nkout/gold/chance_pi/generated/ChancePI-DesAlex-preview.png

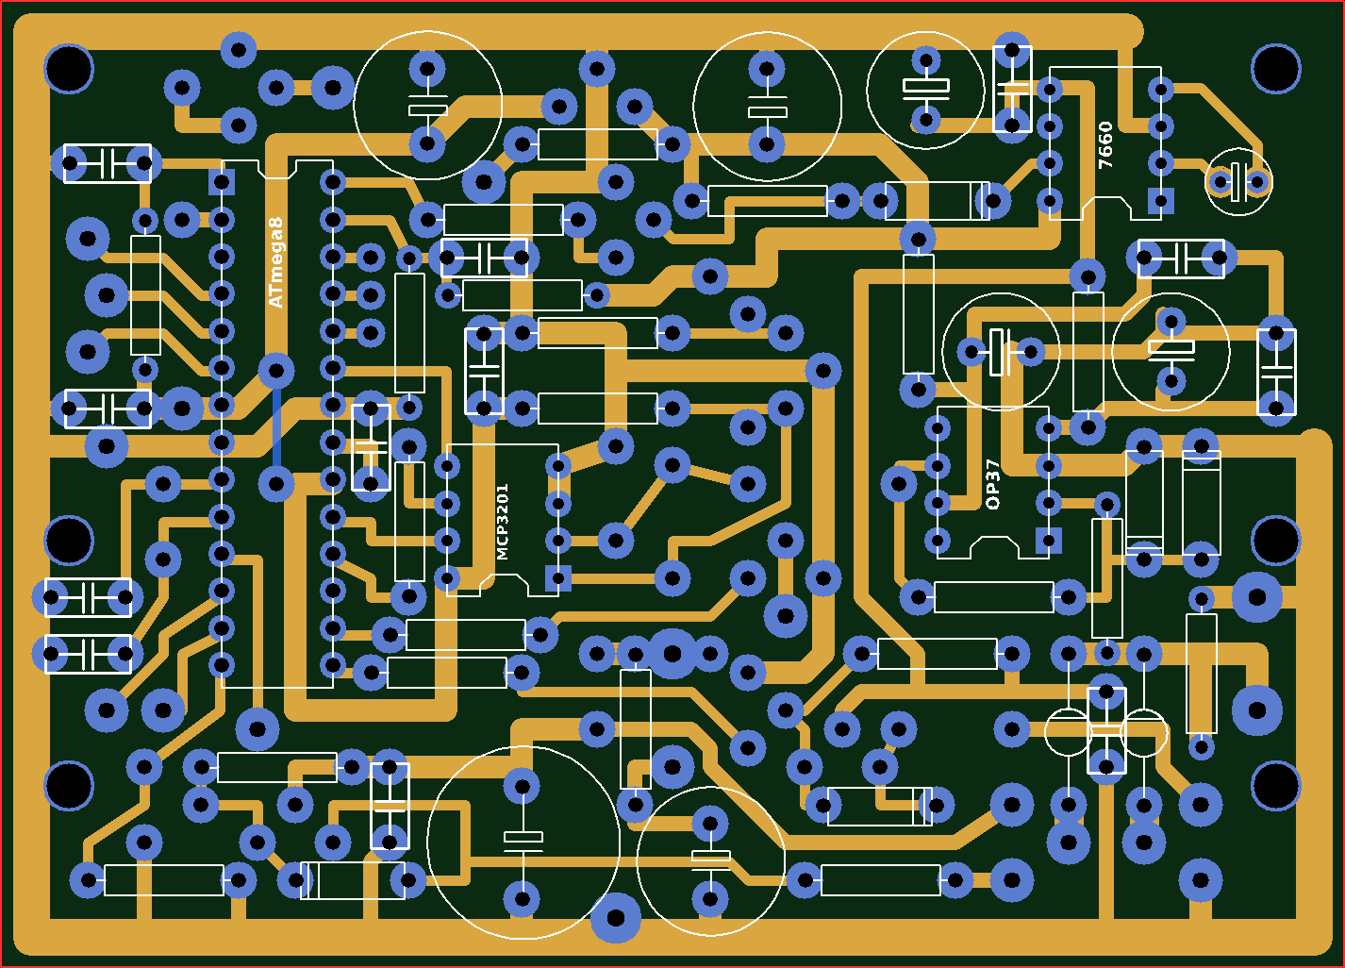
chance_pi/generated/ChancePI-DesAlex-preview.png
