nkout/gold/chance_pi/generated/ChancePI-Keyboard-preview.png

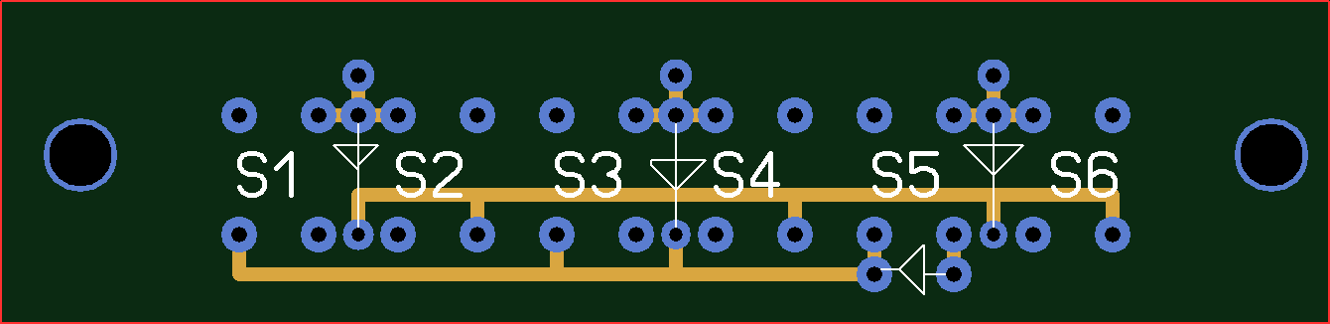
chance_pi/generated/ChancePI-Keyboard-preview.png
