nkout/gold/chance_pi/original/sheme.gif

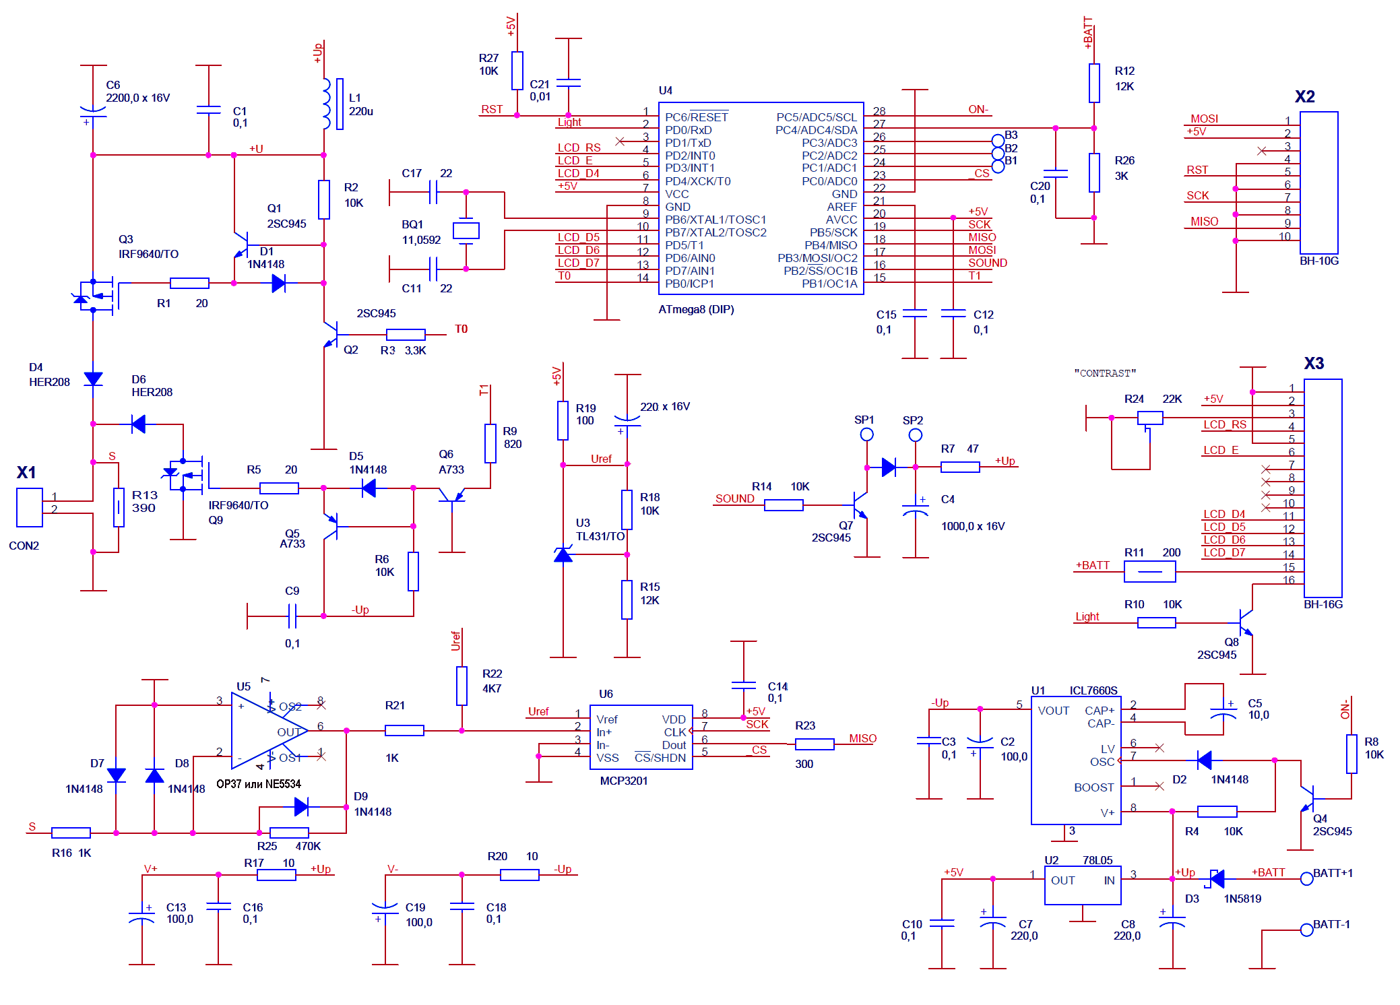
chance_pi/original/sheme.gif
