nkout/gold/tgsl/gerbers/try_03/TGSL-Geotech-v3-preview.png

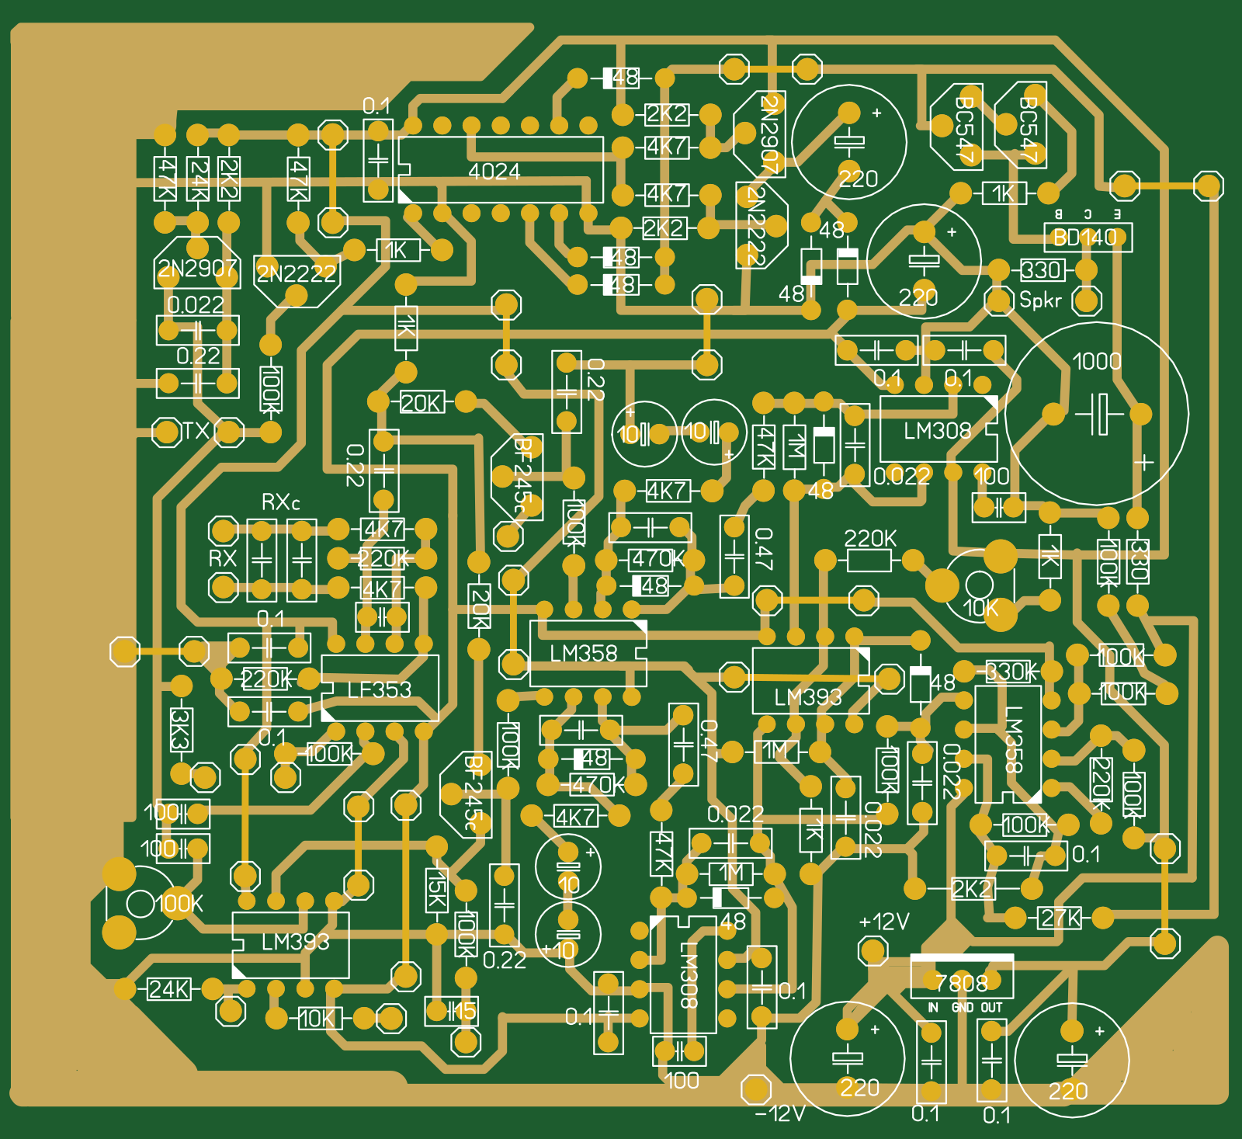
tgsl/gerbers/try_03/TGSL-Geotech-v3-preview.png
