nkout/gold/tgsl/gerbers_generated/review_03/drill_sizes.png

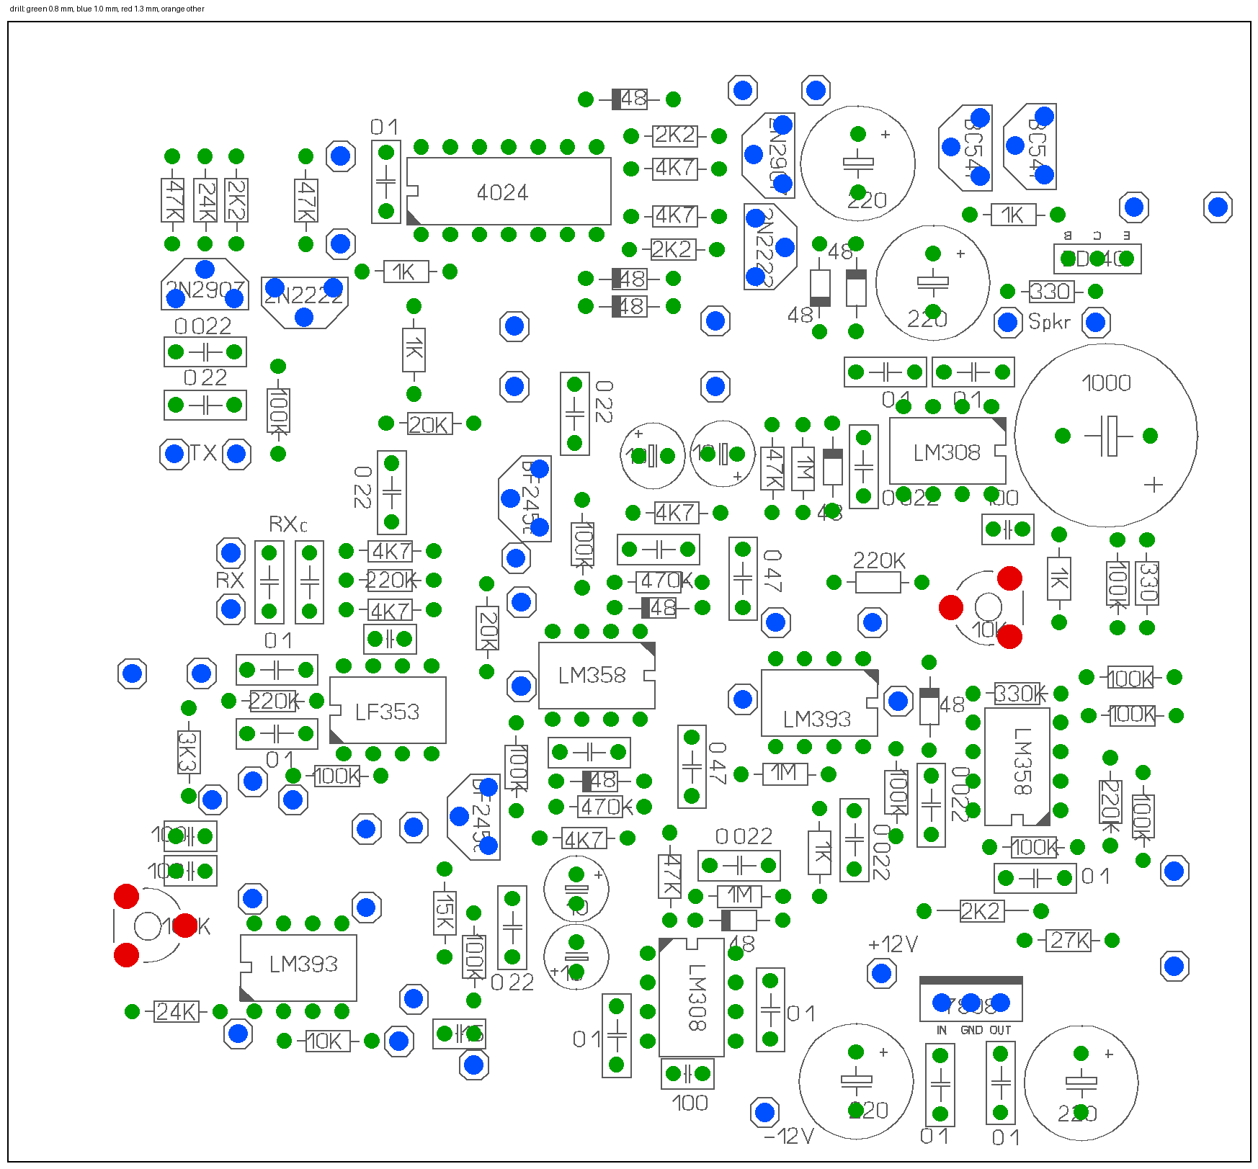
tgsl/gerbers_generated/review_03/drill_sizes.png
