nkout/gold/tgsl/parts/TGSL_PARTS1.xls

Quantity | Capacitors | Part numbers |  | Order from
3 | C8,C12,C15 | 490-3862-ND | CAP CER 220000PF 50V Y5V RADIAL (220n) | www.digikey.com
4 | C3,C4,C5,C28 | P1168-ND | 220UF 16V POLARIZED | www.digikey.com
6 | C13,C16,C20,C23,C24,C25 | 490-3826-ND | CAP CER 22000PF 50V X7R RADIAL (22n) | www.digikey.com
2 | C18,C21 | 490-3865-ND | CAP CER 470000PF 50V Y5V RADIAL (470n) | www.digikey.com
4 | C9,C10,C19,C22 | 490-3677-ND | CAP CER 100PF 50V C0G RADIAL | www.digikey.com
4 | C14,C17, | P5148-ND | 10UF 25V POLARIZED | www.digikey.com
 |  | or..
2 | C14,C17, | P1175-ND | 4.7UF BIPOLAR | www.digikey.com
1 | C27 | P10279-ND | CAP 1000UF 25V ELECT FC RADIAL | www.digikey.com
1 | C7 | 490-3679-ND | CAP CER 10PF 50V C0G RADIAL | www.digikey.com
11 | C26 (& ALL BYPASS CAPACITORS) | 4452634-ND | CAP CER 0.1UF 100V X7R 10% RAD | www.digikey.com
1 | C11 | 478-4845-ND | CAP CER 15PF 100V 5% NP0 RADIAL | www.digikey.com
1 | C1 | P4667-ND | CAP .22UF 50V POLY B SERIES | www.digikey.com
1 | C2 | P4586-ND | CAP .022UF 50V POLY B SERIES | www.digikey.com
1 | C6 | P4515-ND | CAP .015UF 50V STACK METAL FILM | www.digikey.com
 | Resistors
4 | R32,R34,R3,R6 | P47KBACT-ND | 47K | www.digikey.com
11 | R17,R18,R22,R23,R28,R30,R40,R42,R49,R50,R8 | P100KBACT-ND | 100K | www.digikey.com
1 | R6 | P22KBACT-ND | 22K | www.digikey.com
6 | R9,R10,R13,R14,R41,R53 | P4.7KBACT-ND | 4.7K | www.digikey.com
1 | R21 | 24KQBK-ND | 24K | www.digikey.com
2 | R25,R26 | 20KQBK-ND | 20K | www.digikey.com
1 | R45, | 27KQBK-ND | 27K | www.digikey.com
2 | R48,R51 | 200KQBK-ND | 200K | www.digikey.com
3 | R5 | P330BACT-ND | 330 | www.digikey.com
1 | R43 | P330KBACT-ND | 330K | www.digikey.com
3 | R33,R35,R54 | P1.0MBACT-ND | 1M | www.digikey.com
2 | R29,R31, | P470KBACT-ND | 470K | www.digikey.com
5 | R27,R37,R38,R4,R7 | P1.0KBACT-ND | 1K | www.digikey.com
1 | R24 | P15KBACT-ND | 15K | www.digikey.com
1 | R20 | P10KBACT-ND | 10K | www.digikey.com
1 | R19 | P3.3KBACT-ND | 3.3K | www.digikey.com
3 | R15,R16,R39 | P220KBACT-ND | 220K | www.digikey.com
4 | R12,R44,R11,R6 | 2.2KQBK-ND | 2.2K | www.digikey.com
 | ICs
1 | U100 | 296-2042-5-ND | CD4024BE | www.digikey.com
1 | U108 | LM7808CTFS-ND | IC REG 1A POS VOLT 3TERM TO-220 | www.digikey.com
1 | U101A,U101B | LF353NFS-ND | LF353N IC OPAMP JFET DUAL HS 8-DIP | www.digikey.com
2 | U102A,U102B,U106A,U106B | LM393AN-ND | LM393AN IC COMPRTR DUAL 0-70DEG C 8-DIP | www.digikey.com
2 | U103A,U103B,U107A,U107B | LM358NFS-ND | LM358N IC OPAMP DUAL 0-70DEG C 8-DIP | www.digikey.com
2 | U104,U105 | 296-7185-5-ND | TL071ACP | www.digikey.com
 |  | or..
 |  | 23464 | LM308N | www.jameco.com
 | Diodes
10 | D3,D4,D5,D6,D7,D8,D9,D10,D11,D12 | 1N4148DICT-ND | DIODE SWITCHING 75V D0-35
 | Transistors
1 | TR3 | BD14016STU-ND | TRANSISTOR PNP 1.5A 80V | www.digikey.com
2 | TR2,TR9 | BC547CGOS-ND | TRANSISTOR NPN 45V | www.digikey.com
2 | TR6,TR8 | P2N2222AGOS-ND | TRANS GP SS NPN LP 40V TO92 | www.digikey.com
2 | TR4,TR5 | 512-BF247A | BF247A | www.mouser.com
 |  | or..
2 | TR4,TR5 | 512-J107 | J107 | www.mouser.com
2 | TR1,TR7 | 863-P2N2907AG | 2N2907 | www.mouser.com
 | Misc
1 | R36 | 652-3386F-1-104LF | 10K POT PCB MOUNT | www.mouser.com
1 | R22 |  | 100K POT LINEAR TAPER | www.mouser.com
1 | R18 |  | 100K POT LINEAR TAPER
1 |  |  | 8 OHM SPEAKER
1 |  | PC6-ND | PCB COPPER CLAD 4 X 6" 1 SIDE | www.digikey.com
6 |  | ED90048-ND | IC SOCKET 8PIN MS TIN/TIN .300 | www.digikey.com
1 |  | ED90049-ND | IC SOCKET 14PIN MS TIN/TIN .300 | www.digikey.com
