nkout/gold/tgsl/gerbers_generated/tgsl_mouser_bom_3boards_v2.csv

Mfr Part Number | Manufacturer | Quantity | Customer Part Number
MBA02040C3300FC100 | Vishay Beyschlag | 10 | R52 R55
MFR-12FTF52-1K | Yageo | 25 | R7 R27 R37 R38 R56
MFR-12FTF52-2K2 | Yageo | 15 | R1 R11 R12 R44
MFR-12FTF52-3K3 | Yageo | 10 | R19
MFR-12FTF52-4K7 | Yageo | 25 | R9 R10 R13 R14 R41 R53
MFR-12FTF52-10K | Yageo | 10 | R20
MFR-12FTF52-15K | Yageo | 10 | R24
MFR-12FTF52-20K | Yageo | 10 | R25 R26
MFR-12FTF52-24K | Yageo | 10 | R2 R21
MFR-12FTF52-27K | Yageo | 10 | R45
MFR-12FTF52-47K | Yageo | 15 | R3 R6 R32 R34
MFR-12FTF52-100K | Yageo | 35 | R8 R17 R23 R28 R30 R40 R42 R49 R50 R51ab
MFR-12FTF52-220K | Yageo | 15 | R15 R16 R39 R48
MFR-12FTF52-330K | Yageo | 10 | R43
MFR-12FTF52-470K | Yageo | 10 | R29 R31
MFR-12FTF52-1M | Yageo | 10 | R33 R35 R54
FG18C0G1H100DNT00 | TDK | 4 | C7 10p
FG18C0G1H150JNT00 | TDK | 4 | C11 15p
FG18C0G1H101JNT06 | TDK | 10 | C9 C10 100p (C19 C22 not needed w TL081)
FG28X7R1H104KNT00 | TDK | 32 | C26 + 9 bypass 100n
B32529C1224J000 | TDK | 4 | C1 220n 5% Tx tuning
MKS2D032201C00KSSD | WIMA | 10 | C8 C12 C15 220n
MKS2D022201A00KSSD | WIMA | 25 | C13 C16 C20 C23 C24 C25 22n + C2 (select)
B32529C1153J000 | TDK | 4 | C6 15n 5% Rx tuning
MKS2D034701E00KSSD | WIMA | 10 | C18 C21 470n 100V
EEU-FC1H100L | Panasonic | 13 | C14 C14b C17 C17b 10u
ECA-1HM221 | Panasonic | 13 | C3 C4 C5 C28 220u
EEU-FR1E102 | Panasonic | 3 | C27 1000u
1N4148TR | onsemi | 35 | D3-D12
BC547CTA | onsemi | 10 | TR2 TR9
PN2222ABU | onsemi | 10 | TR6 TR8 (2N2222A) rotate 180
PN2907ABU | onsemi | 10 | TR1 TR7 (2N2907A) rotate 180
BD140 | STMicroelectronics | 3 | TR3
J113 | onsemi | 10 | TR4 TR5 rotate 180
CD4024BE | Texas Instruments | 3 | U100
LF353P | Texas Instruments | 3 | U101
LM393P | Texas Instruments | 6 | U102 U106
LM358P | Texas Instruments | 6 | U103 U107
TL081CP | Texas Instruments | 6 | U104 U105
MC7808CTG | onsemi | 3 | U108
1-2199298-2 | TE Connectivity | 21 | U101-U107 sockets
1-2199298-3 | TE Connectivity | 3 | U100 socket
PT10LV10-104A2020-PM-S | Amphenol Piher | 4 | R22 GB 100k 5x10 (wiper via wire)
