nkout/gold/(list of files, cad)

Other CAD files:
tgsl/trevo/proteus/TREVO METAL DISC.DXF
