nkout/gold/tgsl/design/PCB.pdf

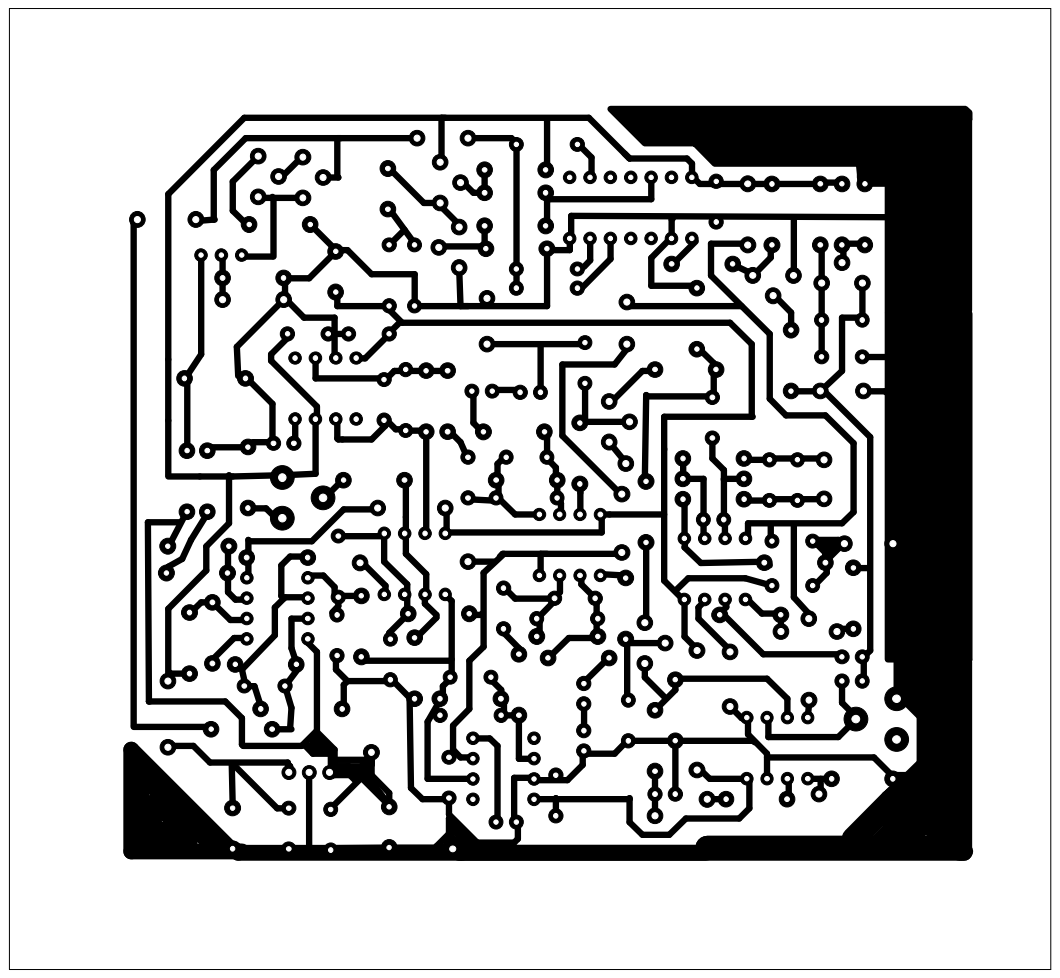
[picture p80: page 1]
