nkout/gold/tgsl/design/Placement OC.pdf

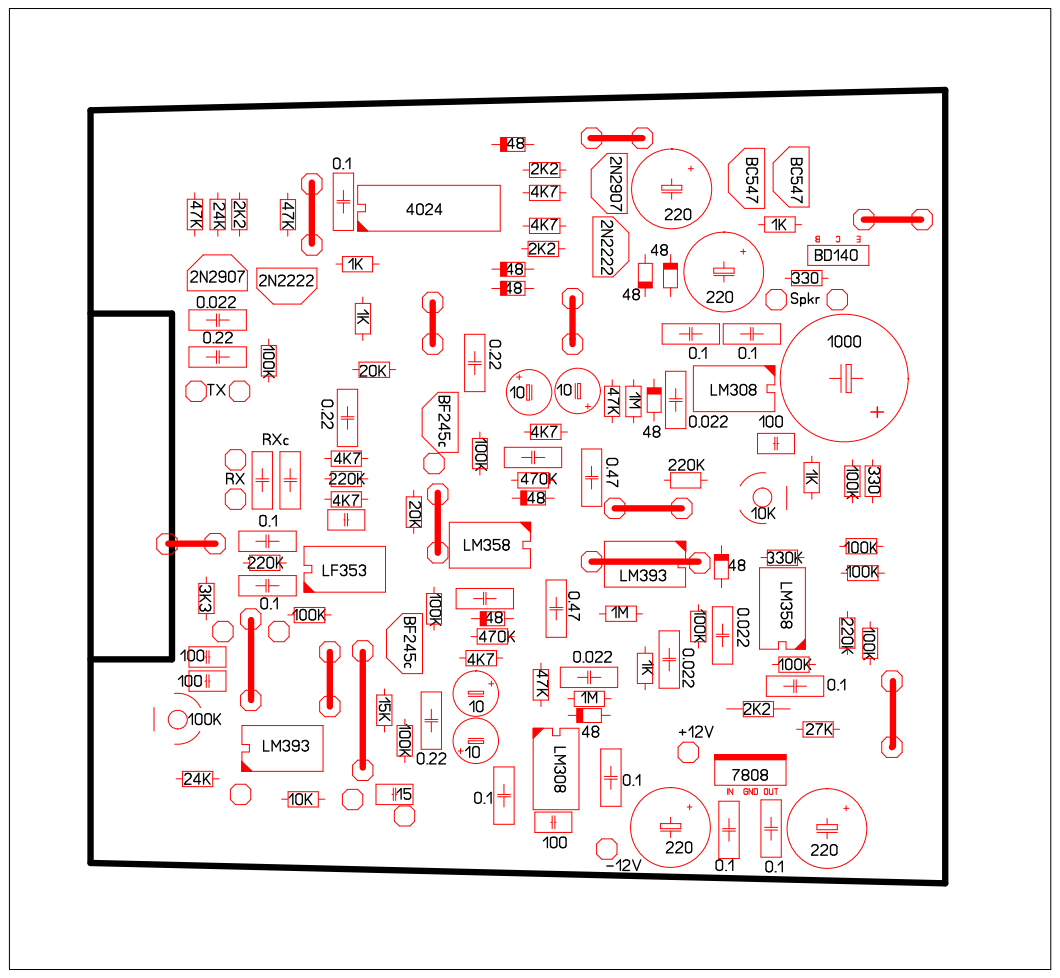
[picture p81: page 1]
