nkout/gold/tgsl/design/Placement.pdf

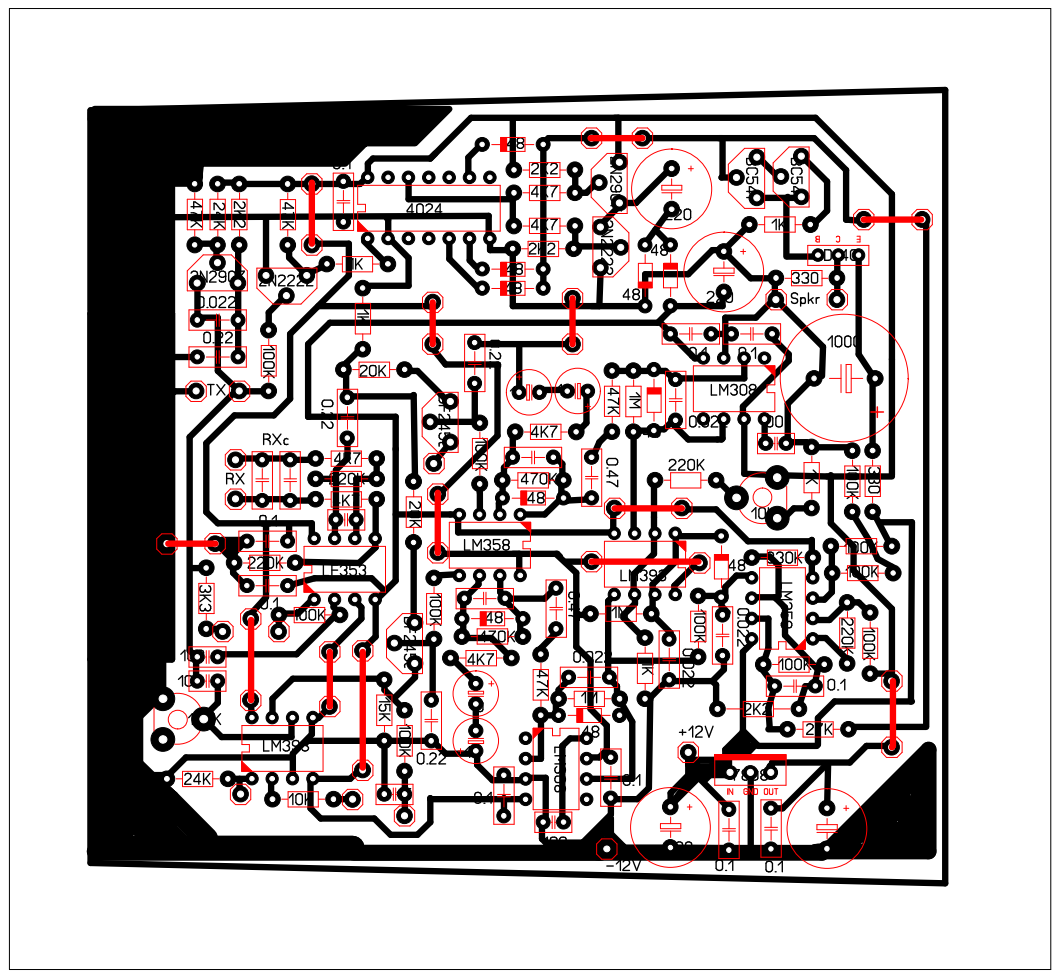
[picture p82: page 1]
