nkout/gold/tgsl/design/Schematic.pdf

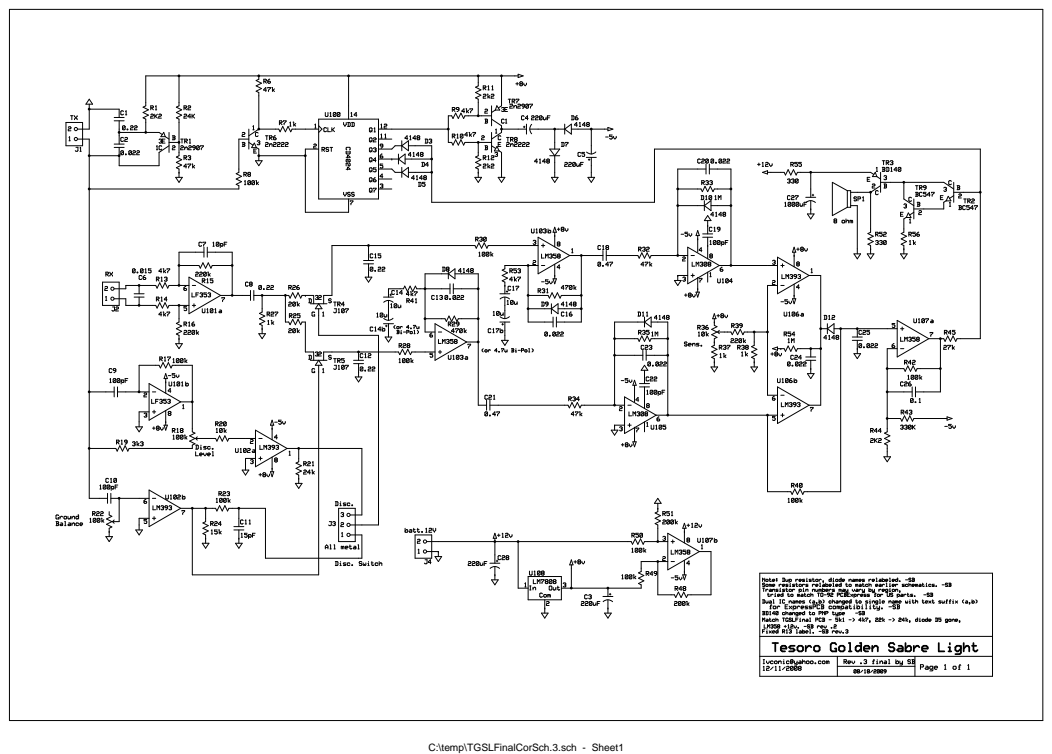
[picture p83: page 1]

C:\temp\TGSLFinalCorSch.3.sch - Sheet1
