nkout/gold/tgsl/trevo/tgsl-pdfs/Mascara de componentes.pdf

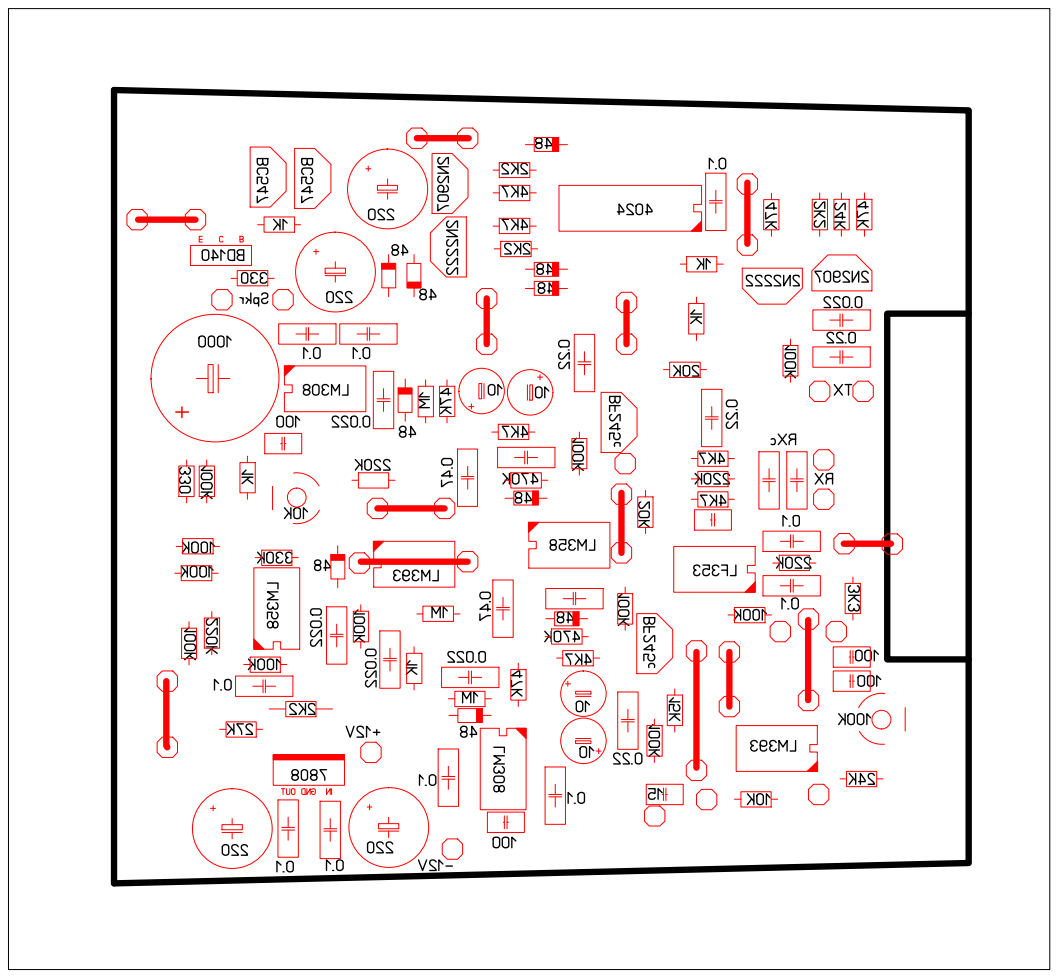
[picture p84: page 1]
