nkout/gold/tgsl/trevo/proteus/TREVO METAL DISC.PDF

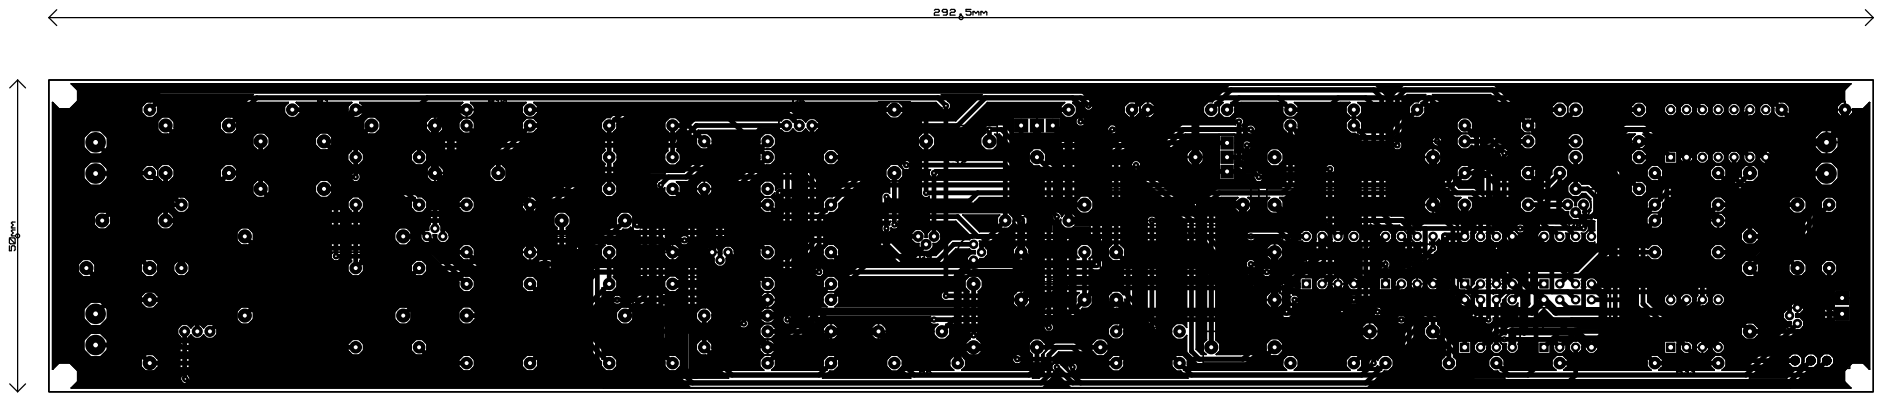
[picture p85: page 1]
