nkout/gold/tgsl/trevo/tgsl-pdfs/TGSL- PCB.pdf

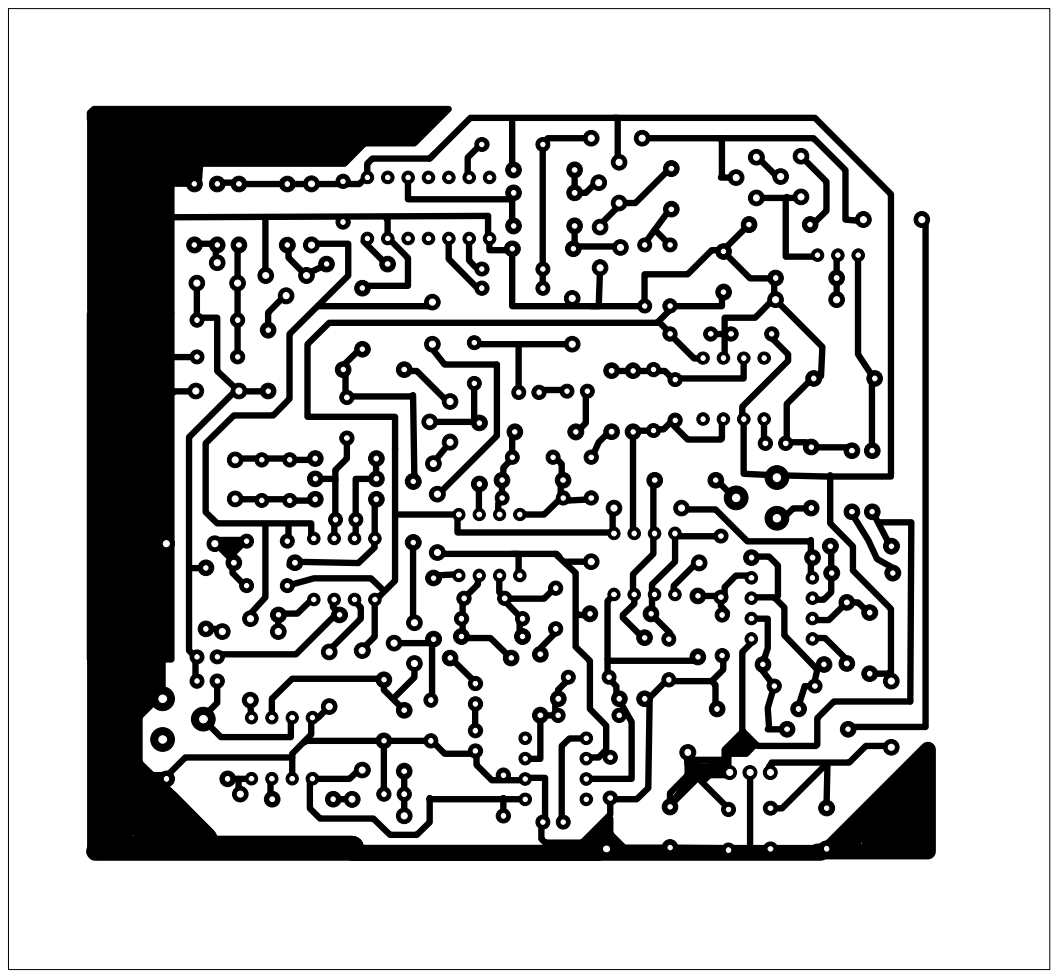
[picture p86: page 1]
