nkout/gold/tgsl/trevo/proteus/TREVO METAL DISC (2).PDF

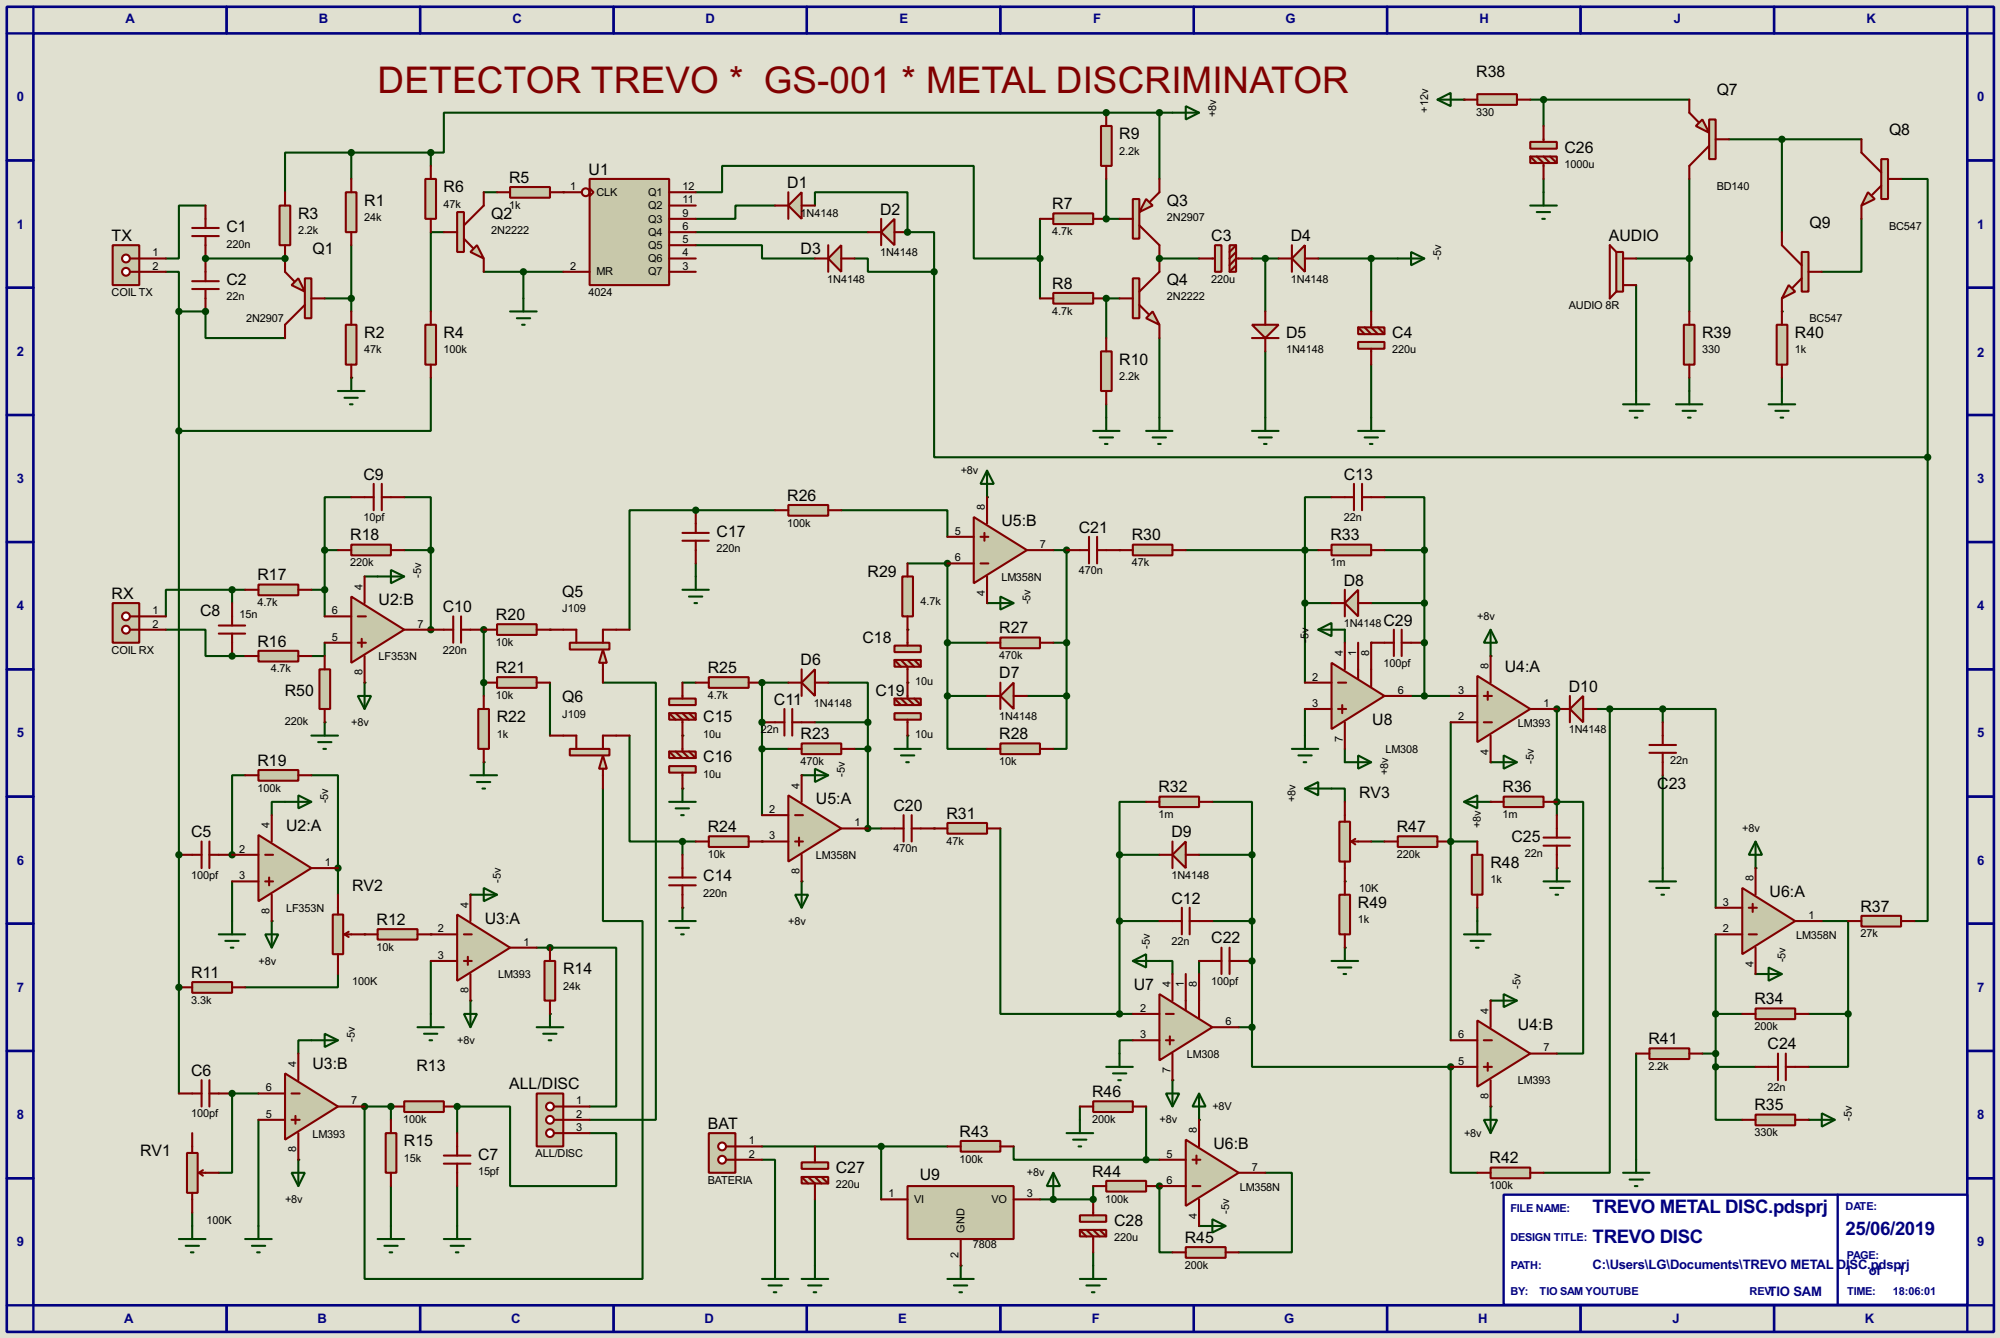
[picture p87: page 1]

DETECTOR TREVO * GS-001 * METAL DISCRIMINATOR

TREVO METAL DISC.pdsprj

DESIGN TITLE: TREVO DISC
