nkout/gold/(list of files, drawings)

Other design files:
chance_pi/original/Chance layout from DesAlex.lay
chance_pi/original/keyboard.lay6
tgsl/trevo/proteus/TREVO METAL DISC.pdsprj
