nkout/gold/(commit log)

2026-10-22 Restructure tgsl: unpack archives into topic folders
    Unzip/unrar every archive in tgsl/ and sort the contents into
    design/, gerbers/, reviews/, parts/, datasheets/, docs/ (+ docs/coil/)
    and trevo/ (gerbers-pcbway/, gerbers-x2/, proteus/, tgsl-pdfs/).
    Exact duplicates are kept once. The original .zip/.rar files are
    removed; they remain in history. README.md documents the layout and
    where each folder came from.
2026-10-22 Add review 02: validation of gerber try 02
    Try 02 fixes all review 01 issues; copper, drills and mask still match
    PCB.pdf exactly. New: silkscreen lost its 21 decimal points (print only),
    and left-edge copper clearance is 0.30 mm.
2026-10-22 Add review 03 and reusable gerber check tools
    Try 03 fixes both review 02 issues (silk decimal points restored, copper
    now 0.80 mm from the board edge). Copper, holes, mask, links and silk
    match the source PDFs exactly, and the mirror is confirmed against
    Placement.pdf. Before ordering: BD140 and 1000 uF holes must go from
    0.8 to 1.0 mm.
    tools/ holds the checks used for this review (run_all.sh fits the
    PDF-to-gerber transform itself, so it runs on new tries unchanged),
    plus copies of opencode's try 02 scripts with notes.
2026-10-22 try_04: fix hole sizes from review 03
    Gerbers are byte-identical to try 03; only PTH.drl changed:
    BD140 0.8 -> 1.1 mm (3 holes), 1000 uF 0.8 -> 1.0 mm (2 holes),
    7808 1.0 -> 1.1 mm (3 holes). tools/run_all.sh try_04 try_03 passes
    every check; smallest annular ring is now 0.233 mm.
